camstillo/PacSatDocs/Hardware/Rev_E/PacSat_Dev_RevE_722024/PacSat_Dev_RevD_240614.jpg

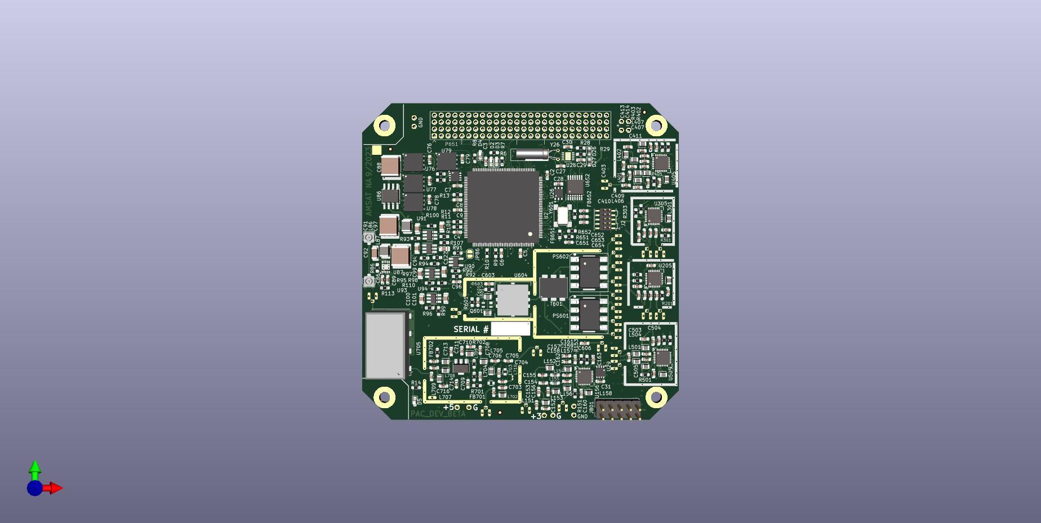
Hardware/Rev_E/PacSat_Dev_RevE_722024/PacSat_Dev_RevD_240614.jpg
