camstillo/PacSatDocs/Hardware/Rev_E/PacSat_Dev_RevE_722024/PacSat_1-1_check.xlsx

 | Radio Amateur Satellite
 | PatSacDev | 1 to 1 check
designator | issue | p/n received | comments
C154 | part too small for layout | part matches BOM part
C29, C30 | part too big for layout | part matches BOM part
C601 | no board identifier on board | part matches BOM part
C92, C96, C714 | part too big for layout | part matches BOM part
D2 ,D5 | D2 part too small for layout, D5 part too big for layout | part matches BOM part
FB701, FB702 | part too big for layout | part matches BOM part
L061 | no board identifier on board | part matches BOM part
L154, L155. L702 | part too small for layout | part matches BOM part
L401 | part too small for layout | part matches BOM part
L402, L403, L501, L502, L503, L504 | part too small for layout | part matches BOM part
L706 | no board identifier on board | part matches BOM part
L708 | no board identifier on board | part matches BOM part
L710 | part too small for layout | part matches BOM part | not sure if we have the correct location
R201, R301, R401, R501 | no board identifier on board | part matches BOM part
R603 | no board identifier on board | part matches BOM part
R606 | no board identifier on board | part matches BOM part
R701 | no board identifier on board | part matches BOM part
R88, R99, R104 | no board identifier on board | part matches BOM part
U206 | part is 4pin, layout is 6pin, but part fits lyout spacing | part matches BOM part
U28 | part too big for layout | part matches BOM part
U90, U95 | part too big for layout | part matches BOM part
L703 | no board identifier on board | part matches BOM part
