camstillo/PacSatDocs/Hardware/Amplifier_Test_Board/Amplifier_Test/Amplifier_Test.kicad_pcb

## KiCad design LL-User-Adapter/LL-User-Adapter.kicad_sch

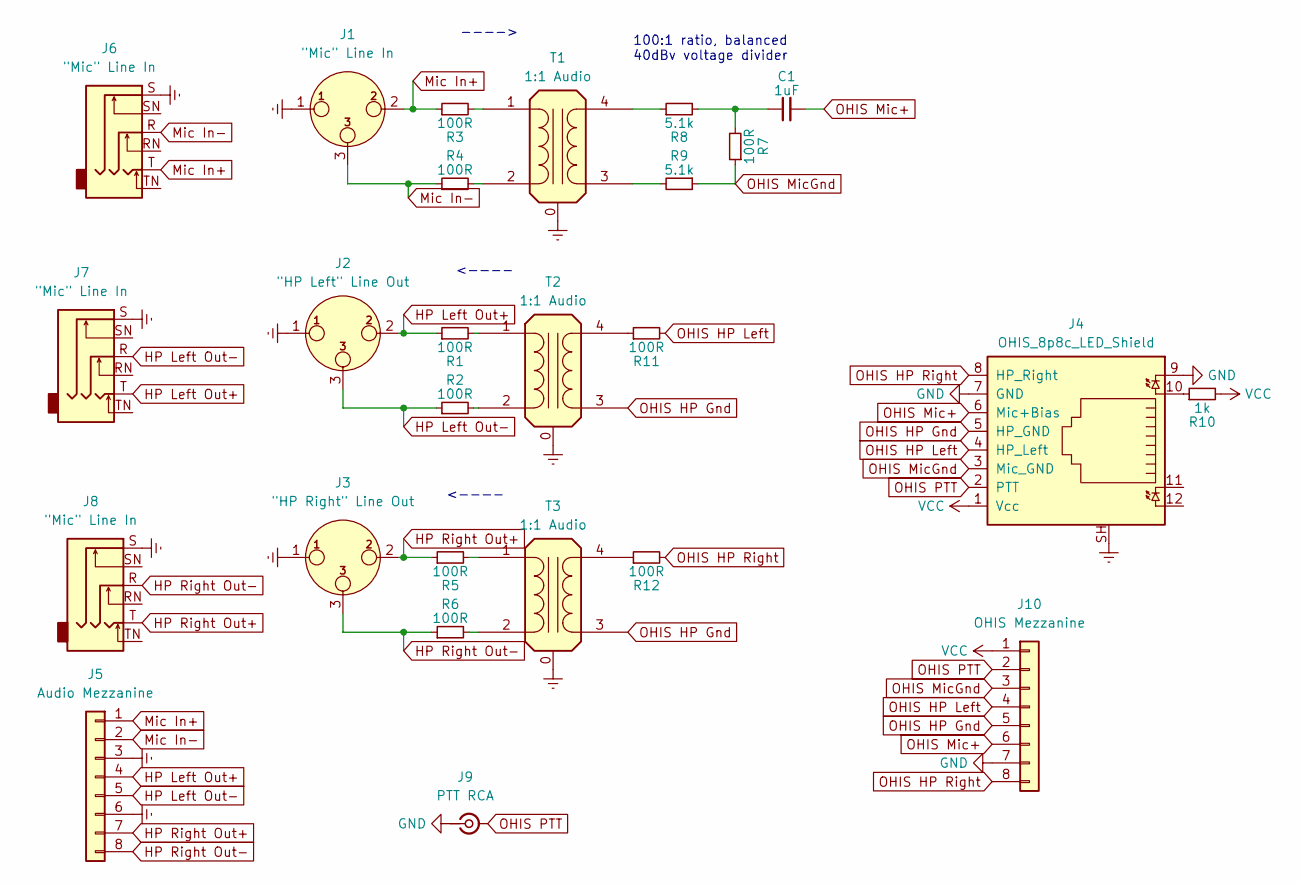
[picture p2: schematic LL-User-Adapter.kicad_sch]

Parts:
C1: 1uF
J1, J6, J7, J8: "Mic" Line In
J2: "HP Left" Line Out
J3: "HP Right" Line Out
J4: OHIS_8p8c_LED_Shield
J5: Audio Mezzanine
J9: PTT RCA
J10: OHIS Mezzanine
R1, R2, R3, R4, R5, R6, R7, R11, R12: 100R
R8, R9: 5.1k
R10: 1k
T1, T2, T3: 1:1 Audio

Connections:
Earth: J1.1, J2.1, J3.1, J4.SH, J5.3, J5.6, J6.S, J7.S, J8.S, T1.0, T2.0, T3.0
GND: J4.7 (GND), J4.9, J9.1 (In), J10.7
HP Left Out+: J2.2, J5.4, J7.T, R1.1
HP Left Out-: J2.3, J5.5, J7.R, R2.1
HP Right Out+: J3.2, J5.7, J8.T, R5.1
HP Right Out-: J3.3, J5.8, J8.R, R6.1
Mic In+: J1.2, J5.1, J6.T, R3.1
Mic In-: J1.3, J5.2, J6.R, R4.1
unnamed: C1.1, R7.2, R8.2
unnamed: J4.10, R10.1
unnamed: R1.2, T2.1 (AA)
unnamed: R2.2, T2.2 (AB)
unnamed: R3.2, T1.1 (AA)
unnamed: R4.2, T1.2 (AB)
unnamed: R5.2, T3.1 (AA)
unnamed: R6.2, T3.2 (AB)
unnamed: R8.1, T1.4 (SB)
unnamed: R9.2, T1.3 (SA)
unnamed: R11.1, T2.4 (SB)
unnamed: R12.1, T3.4 (SB)
OHIS HP Gnd: J4.5 (HP_GND), J10.5, T2.3 (SA), T3.3 (SA)
OHIS HP Left: J4.4 (HP_Left), J10.4, R11.2
OHIS HP Right: J4.8 (HP_Right), J10.8, R12.2
OHIS Mic+: C1.2, J4.6 (Mic+Bias), J10.6
OHIS MicGnd: J4.3 (Mic_GND), J10.3, R7.1, R9.1
OHIS PTT: J4.2 (PTT), J9.2 (Ext), J10.2
VCC: J4.1 (Vcc), J10.1, R10.2

Notes on the sheet:
<----
100:1 ratio, balanced 40dBv voltage divider
---->
