camstillo/PacSatDocs/(commit log)

2024-07-12 Added rev E
    [AX5043_RX.kicad_pcb, AX5043_RX.kicad_sch, BUS_IO_Interface.kicad_sch, Clocks.kicad_sch, PC104_io_conn.kicad_sch, PacSat_1-1_check.xlsx, PacSat_CPU_Pin_Assignment.ods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]
2024-10-18 rearranged files, created REV E, added amplifier test board (WIP)
    [Amplifier_Test.kicad_pcb, Amplifier_Test.kicad_sch, GRF5504_AMP.kicad_sch, Linear_PA.kicad_sch, PowerSupply.kicad_sch]
